mitchgu/6301-temp-sensor/Deliverables/deliverable_4.docx

Deliverable 4 – Mitchell Gu

I don’t have a screenshot with a different temperature because I’m pretty sure it’s IPTAT now.

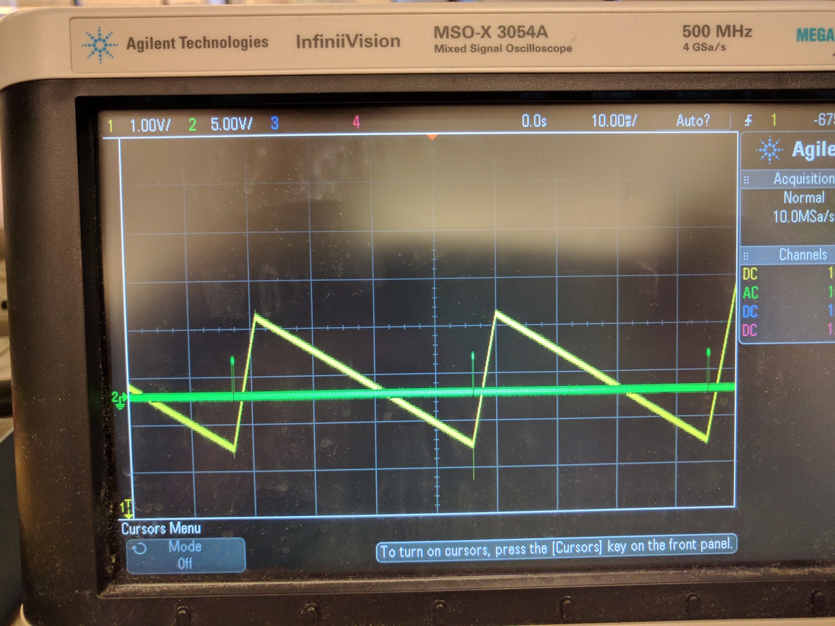
[picture p6: figure]
