mitchgu/6301-temp-sensor/Deliverables/deliverable_2.docx

# 6.301 Project Deliverable 2 – Simulation

# SPICE Simulation

Used a super simple model with same beta as hand calculations:

.model NPN NPN(IS=1E-14 Bf=100 RB=0 RC=0 RE=0)

.model PNP PNP(IS=1E-14 Bf=100 RB=0 RC=0 RE=0)

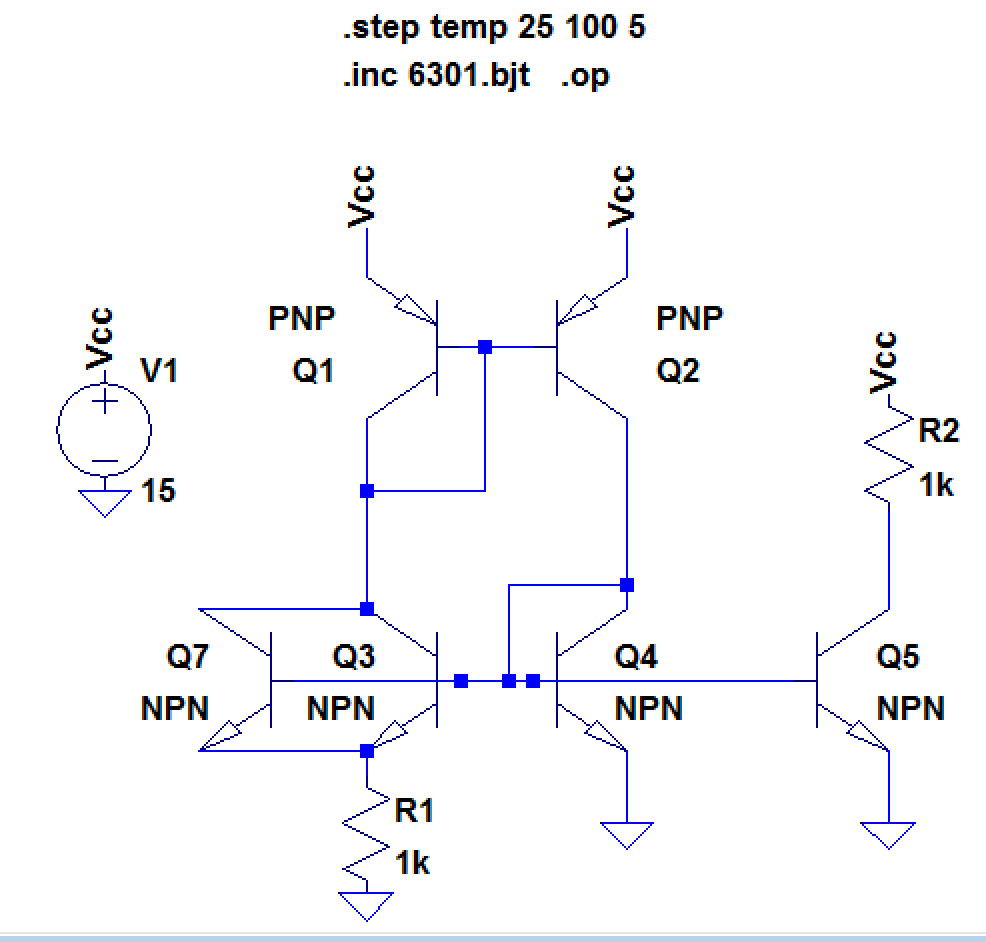
[picture p7: figure]
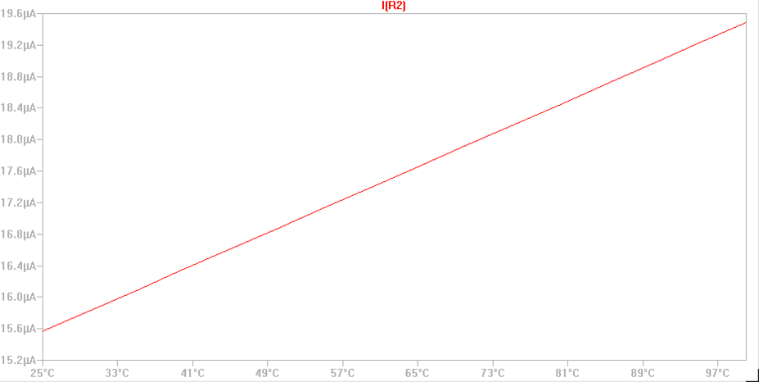
[picture p8: figure]

# Hand calculation vs SPICE simulation

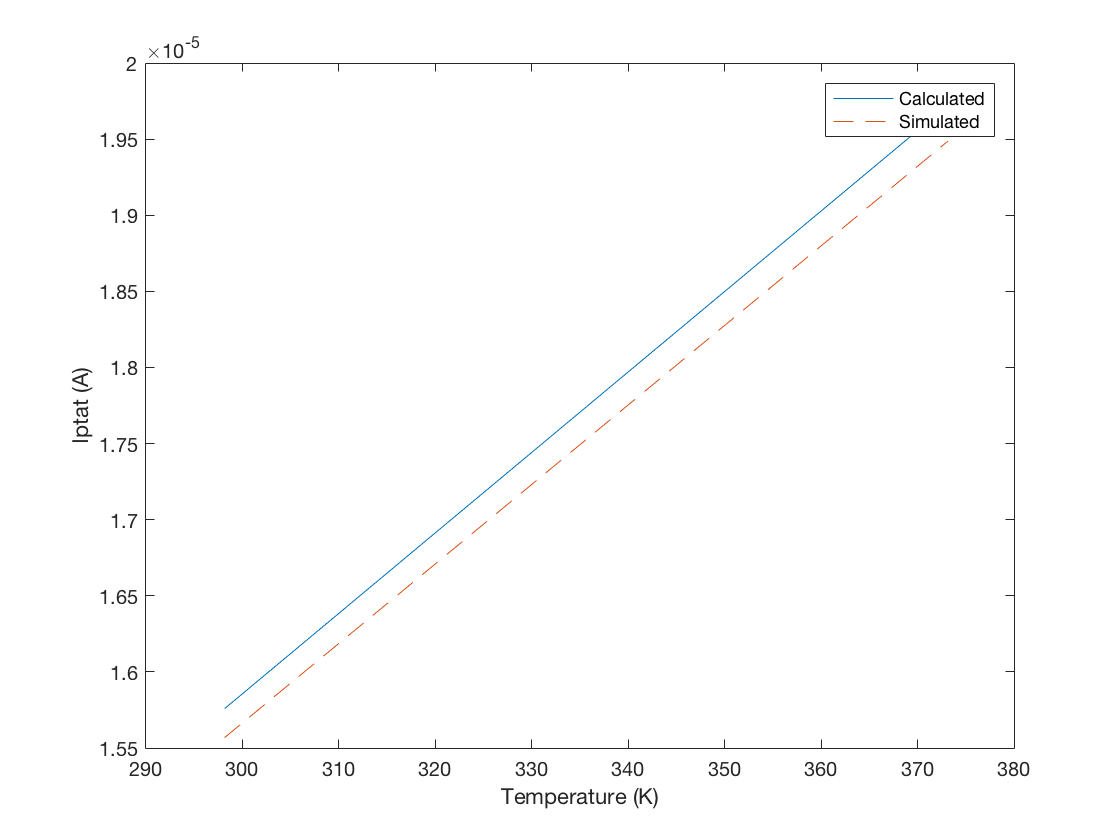
[picture p9: figure]
