mitchgu/6301-temp-sensor/Report/assets/img/adc_sch.png

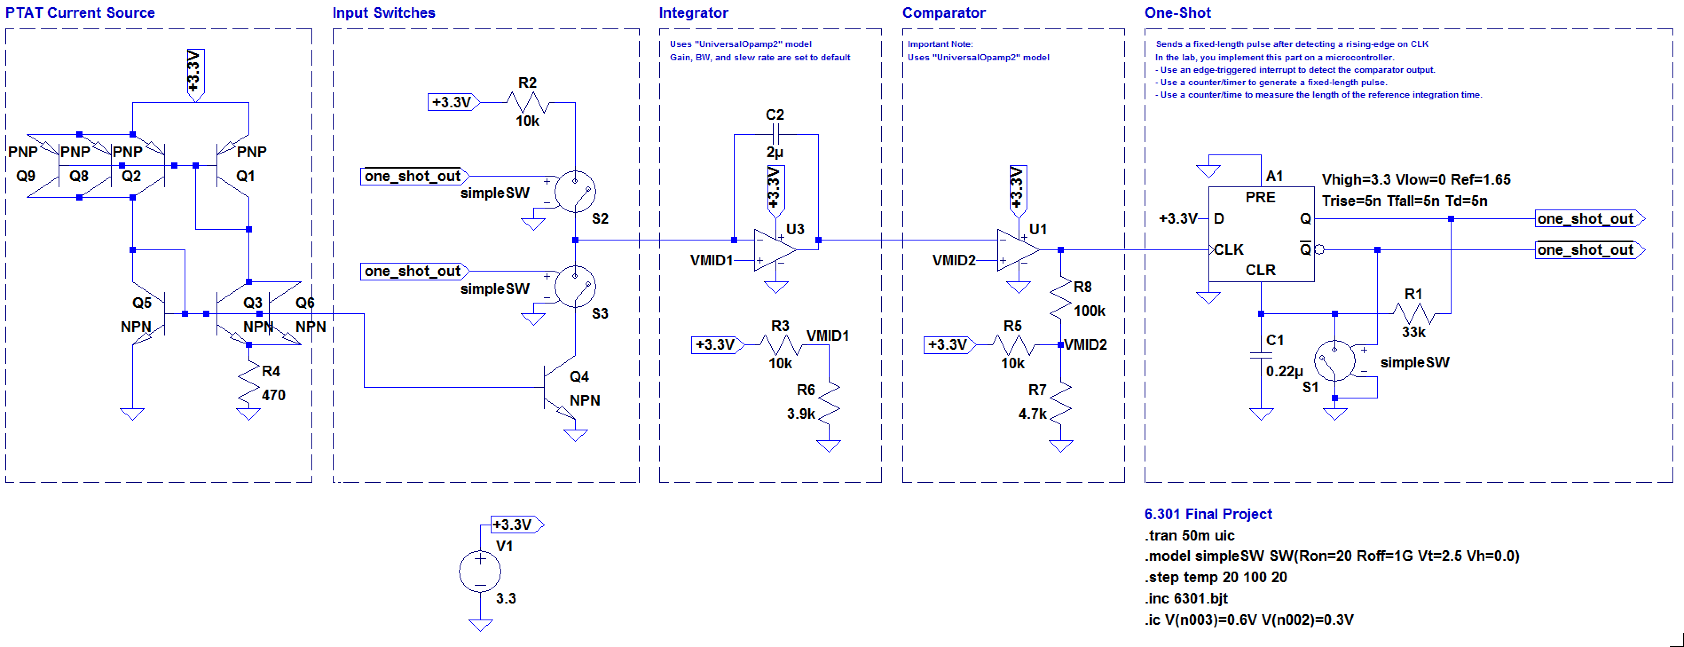
Report/assets/img/adc_sch.png
