mitchgu/6301-temp-sensor/Report/assets/img/adc_sim.png

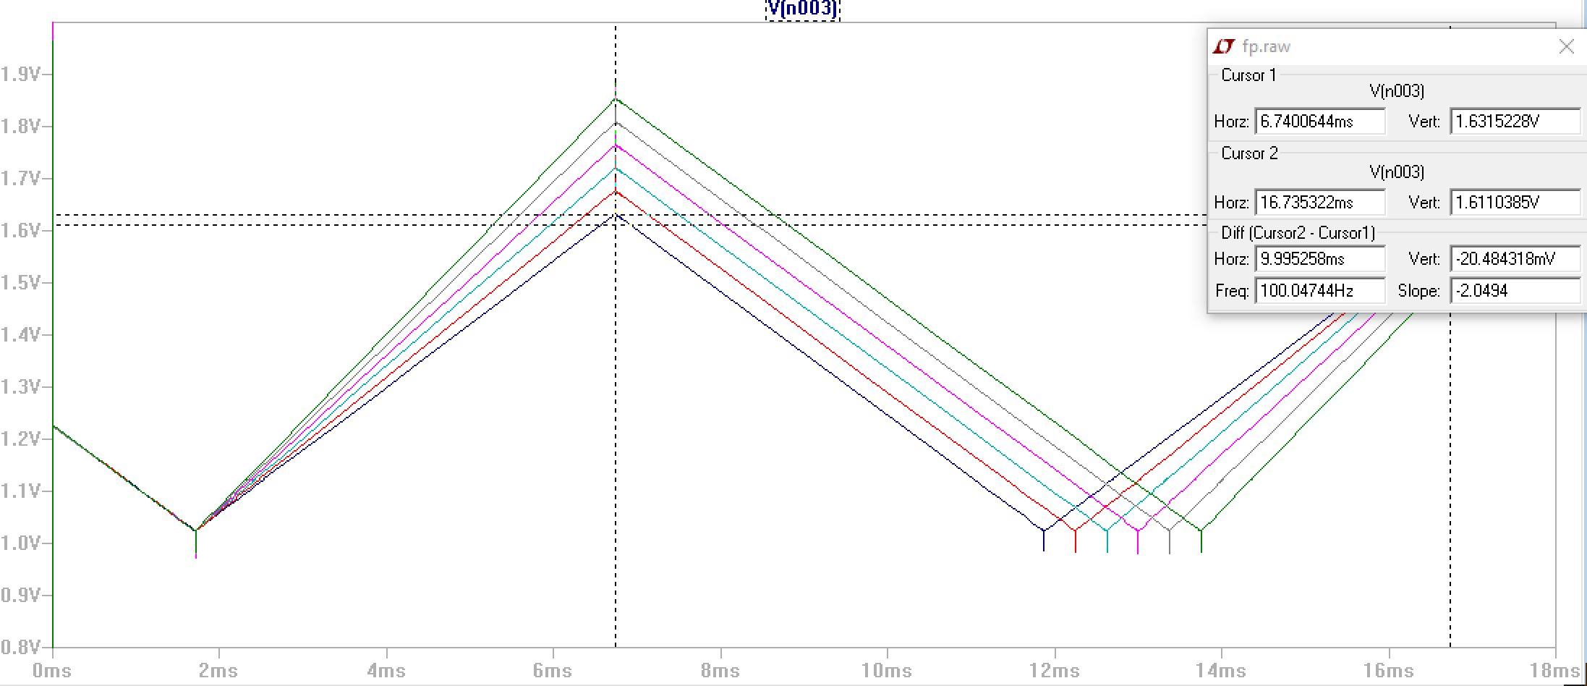
Report/assets/img/adc_sim.png
