mitchgu/6301-temp-sensor/Report/assets/img/downramptime.png

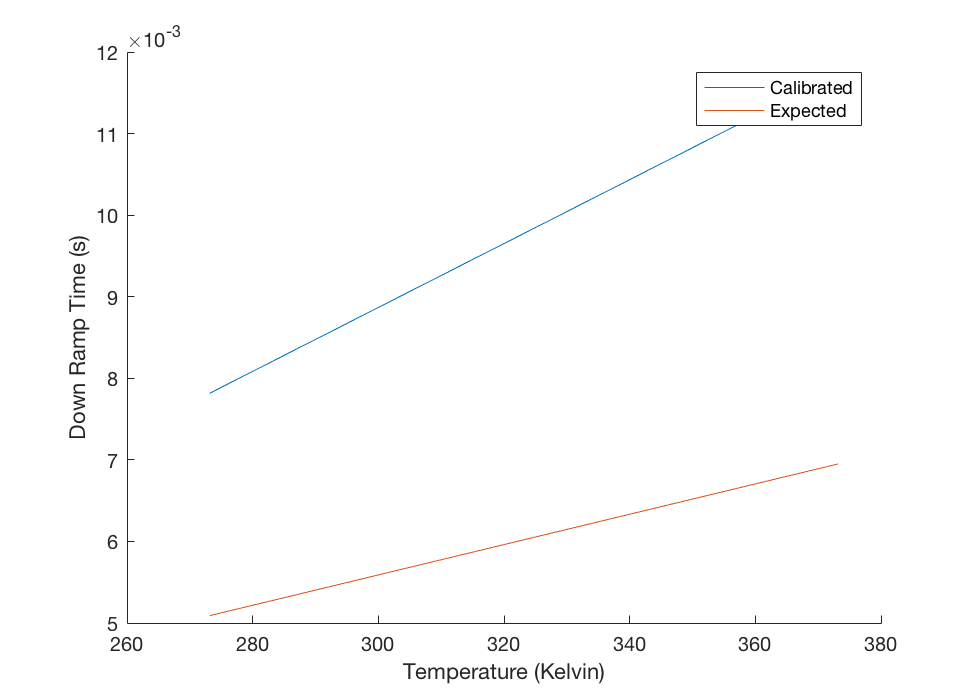
Report/assets/img/downramptime.png
