mitchgu/6301-temp-sensor/Report/assets/img/pcb_bottom_cu.png

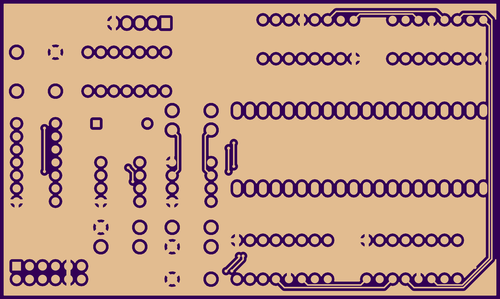
Report/assets/img/pcb_bottom_cu.png
