mitchgu/6301-temp-sensor/Report/assets/img/pcb_top.png

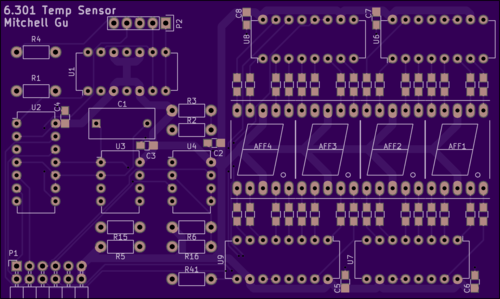
Report/assets/img/pcb_top.png
