mitchgu/6301-temp-sensor/Report/assets/img/ptat_cell.png

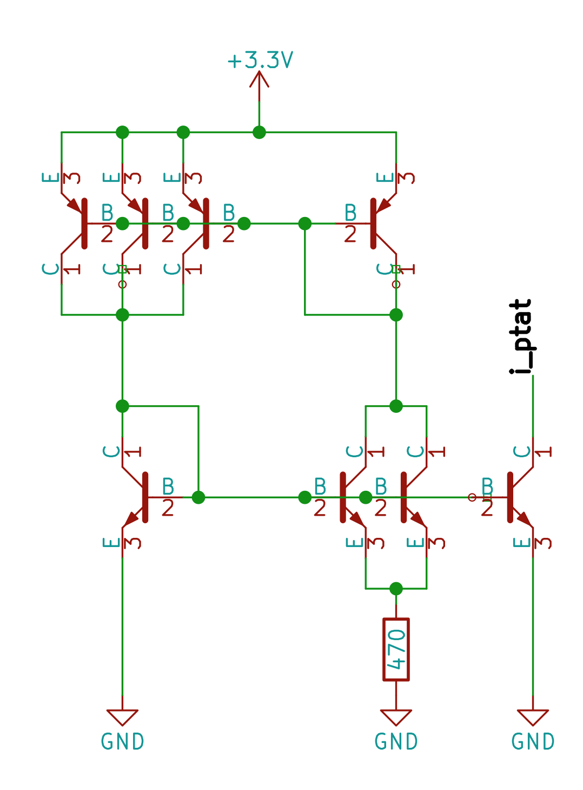
Report/assets/img/ptat_cell.png
