mitchgu/6301-temp-sensor/Report/assets/img/ptat_sim.png

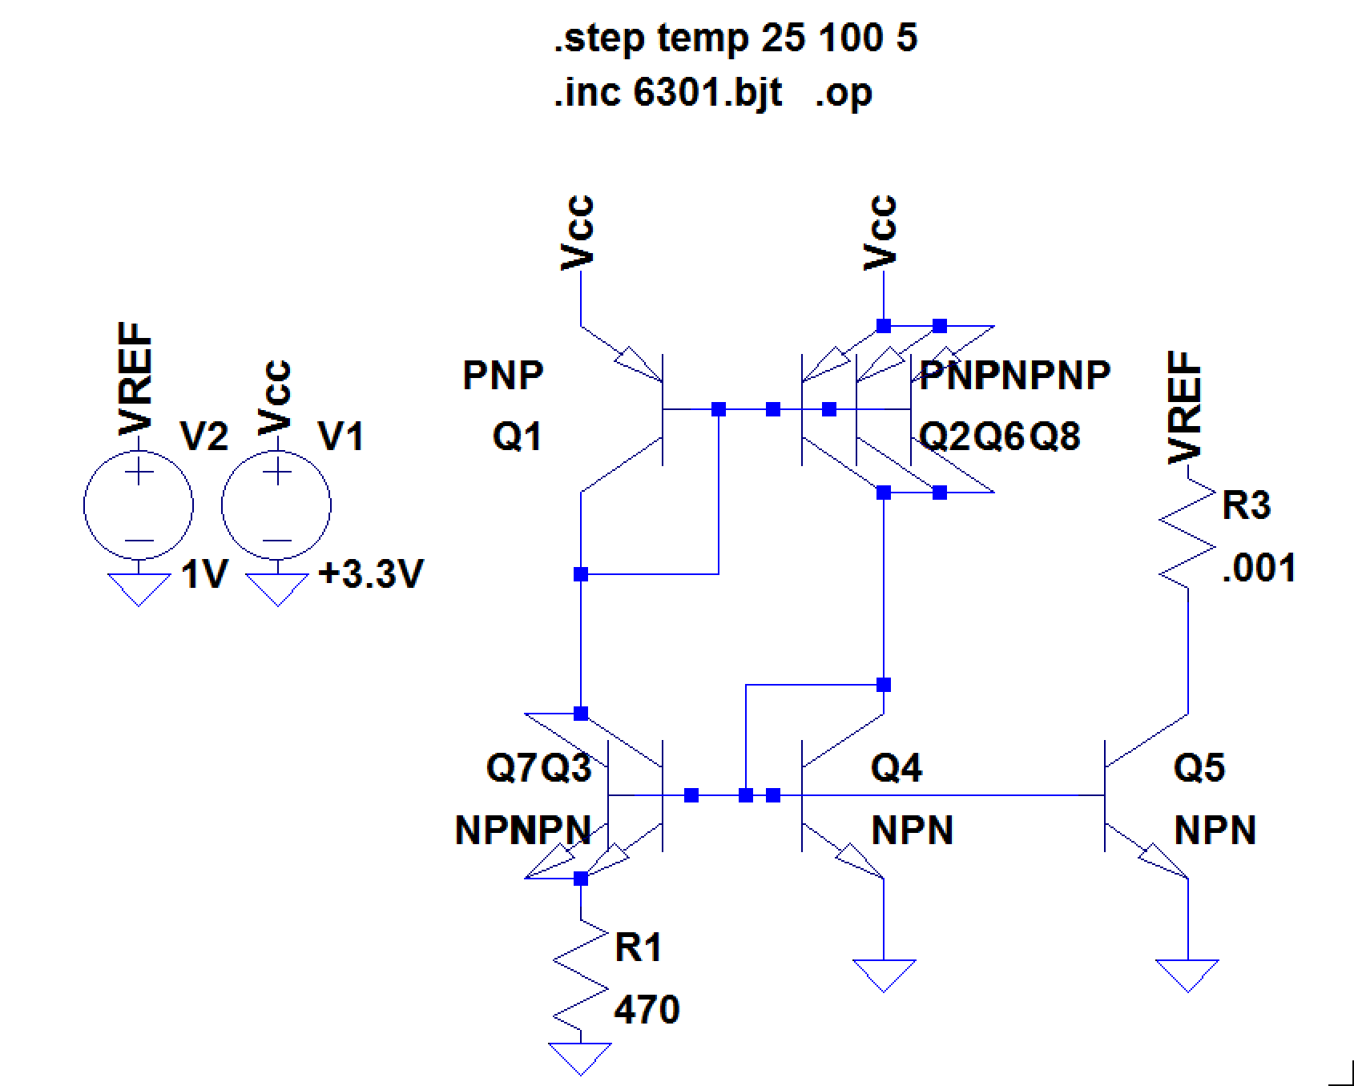
Report/assets/img/ptat_sim.png
