mitchgu/6301-temp-sensor/Report/assets/img/sch.png

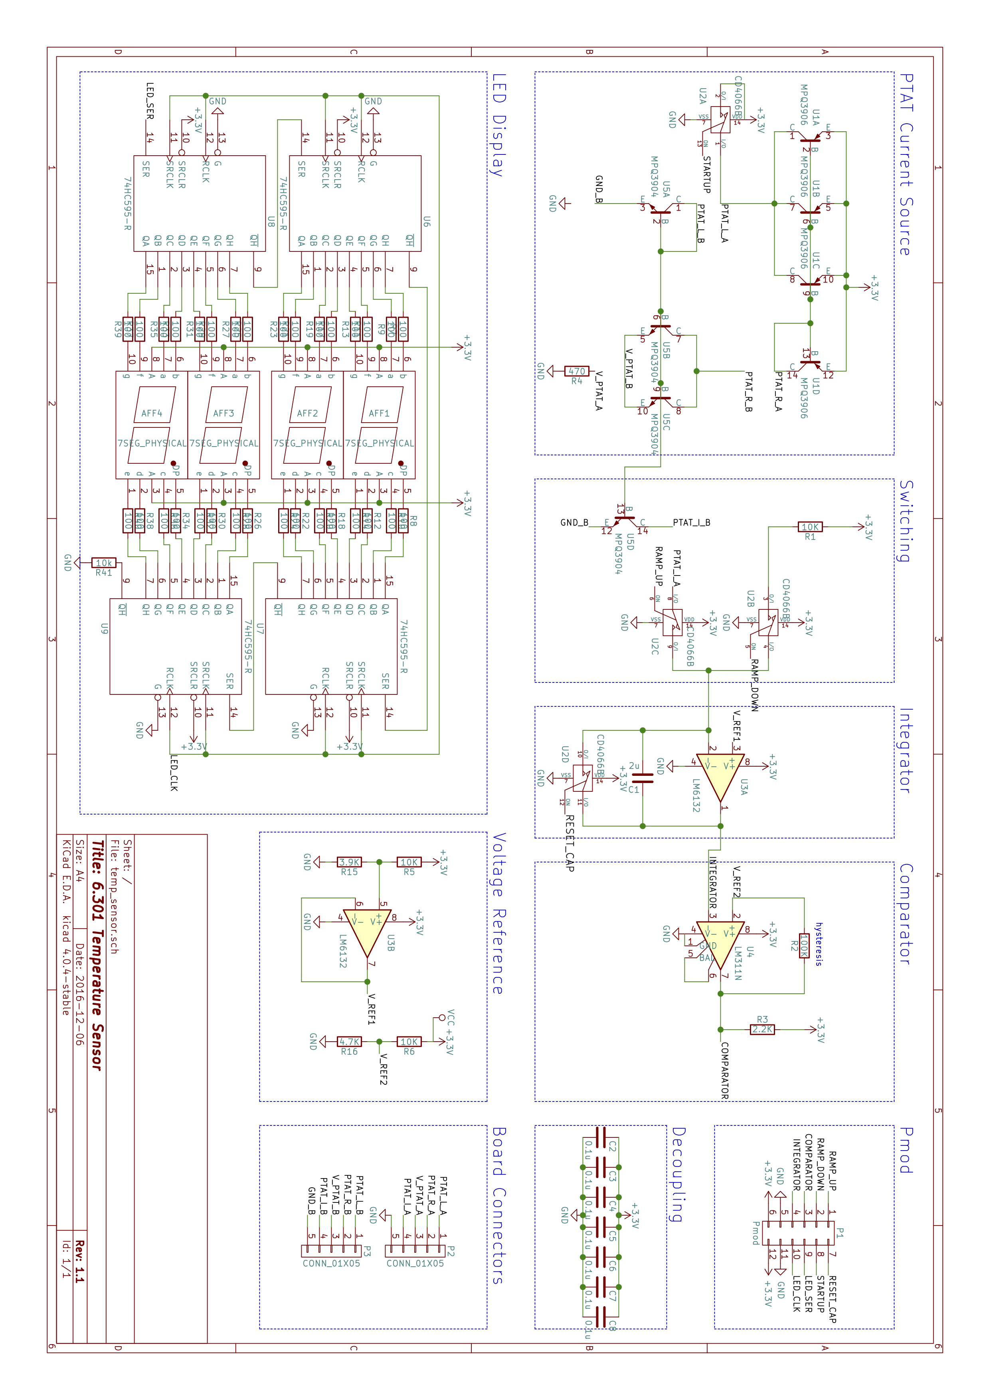
Report/assets/img/sch.png
