mitchgu/6301-temp-sensor/Report/assets/img/silk.png

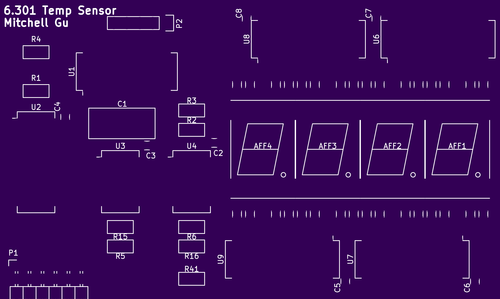
Report/assets/img/silk.png
