mitchgu/6301-temp-sensor/Report/assets/img/temp_plot.png

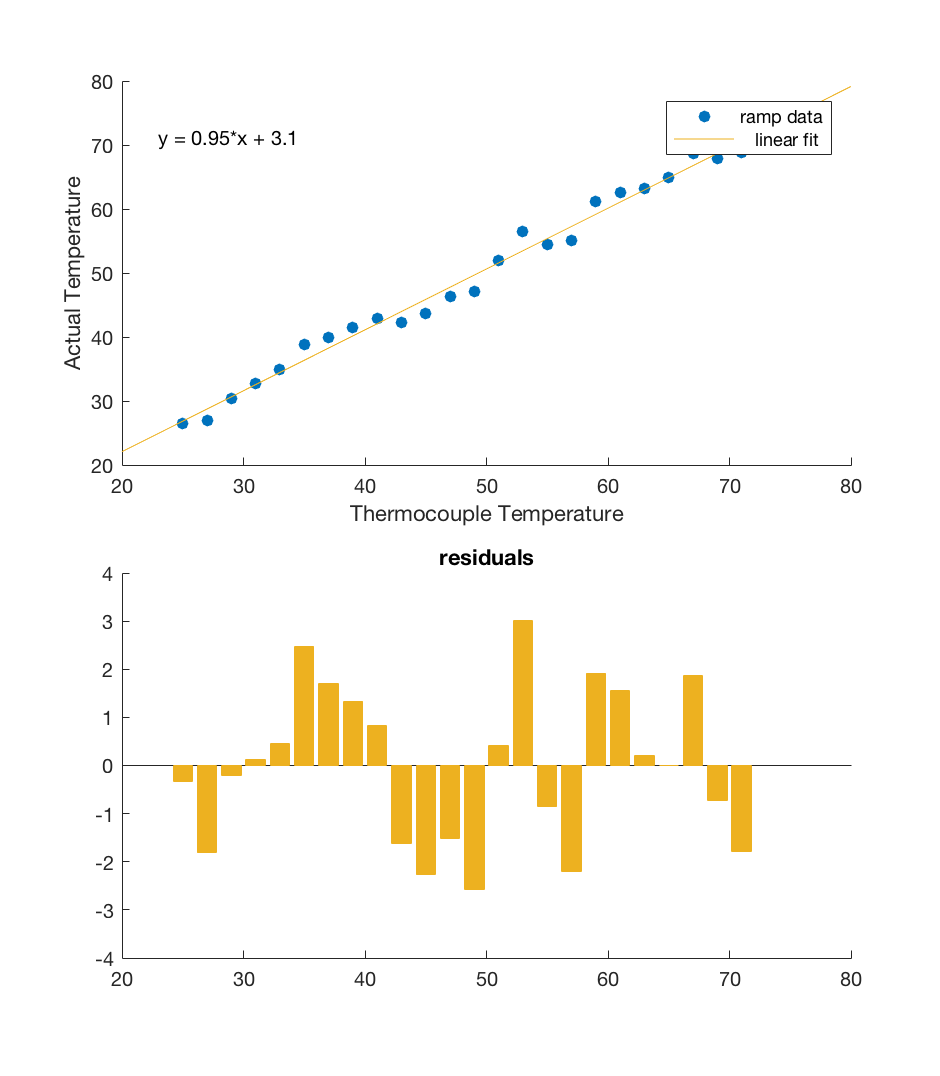
Report/assets/img/temp_plot.png
