mitchgu/6301-temp-sensor/kicad/temp_sensor.pdf

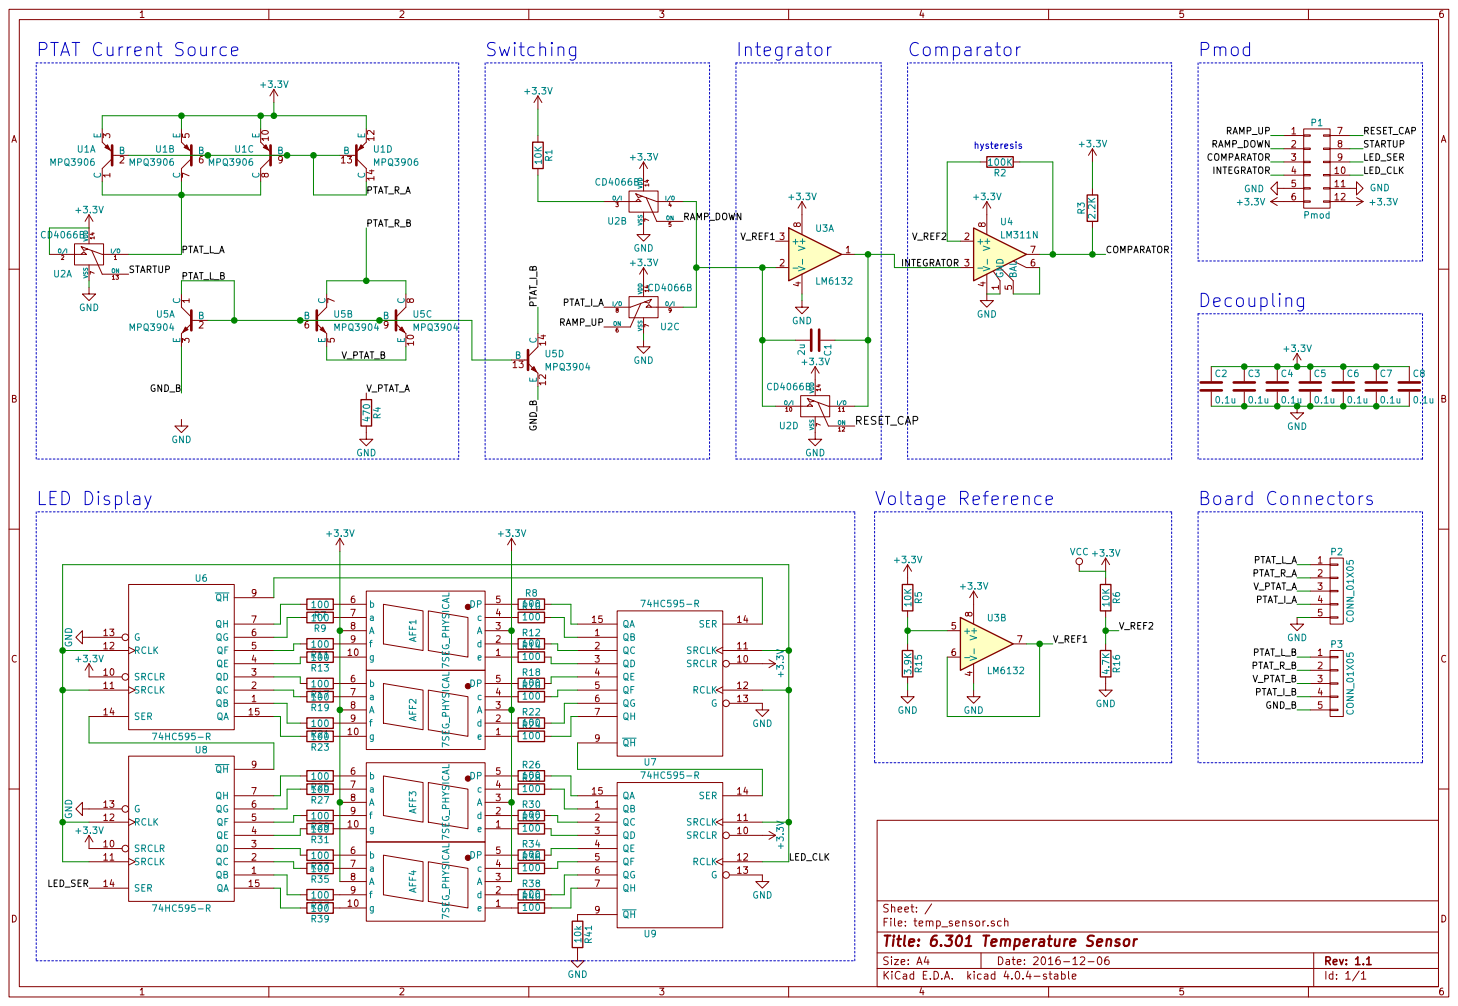
[picture p21: page 1]

f 9 | 2 A

Id: 1/1 Title: 6.301 Temperature Sensor
