mitchgu/6301-temp-sensor/LTSpice/fp.asc

A1: dflop; Vhigh=3.3 Vlow=0 Ref=1.65; Trise=5n Tfall=5n Td=5n
C1: cap; 0.22µ
C2: cap; 2µ
Q1: pnp
Q2: pnp
Q3: npn
Q4: npn
Q5: npn
Q6: npn
Q8: pnp
Q9: pnp
R1: res; 33k
R2: res; 10k
R3: res; 10k
R4: res; 470
R5: res; 10k
R6: res; 3.9k
R7: res; 4.7k
R8: res; 100k
S1: sw; simpleSW
S2: sw; simpleSW
S3: sw; simpleSW
U1: UniversalOpamp2
U2: UniversalOpamp2
U3: UniversalOpamp2
V1: voltage; 3.3
Named nets: 0, +3.3V, one_shot_out, _one_shot_out, VMID1, VMID2
.tran 50m uic
.model simpleSW SW(Ron=20 Roff=1G Vt=2.5 Vh=0.0)
Input Switches
Integrator
Comparator
One-Shot
Sends a fixed-length pulse after detecting a rising-edge on CLK
In the lab, you implement this part on a microcontroller.
- Use an edge-triggered interrupt to detect the comparator output.
- Use a counter/timer to generate a fixed-length pulse.
- Use a counter/time to measure the length of the reference integration time.
Uses "UniversalOpamp2" model
Gain, BW, and slew rate are set to default
Important Note:
Uses "UniversalOpamp2" model
6.301 Final Project
.inc 6301.bjt
.step temp 20 100 20
PTAT Current Source
.ic V(n003)=0.6V V(n002)=0.3V
