mitchgu/6301-temp-sensor/LTSpice/ptat.asc

Q1: pnp
Q2: pnp
Q3: npn
Q4: npn
Q5: npn
Q6: pnp
Q7: npn
Q8: pnp
R1: res; 470
R3: res; .001
V1: voltage; +3.3V
V2: voltage; 1V
Named nets: 0, Vcc, VREF
.inc 6301.bjt
.op
.step temp 25 100 5
