mitchgu/6301-temp-sensor/kicad/temp_sensor.kicad_pcb

## KiCad design kicad/temp_sensor.kicad_pcb (2016-12-13)

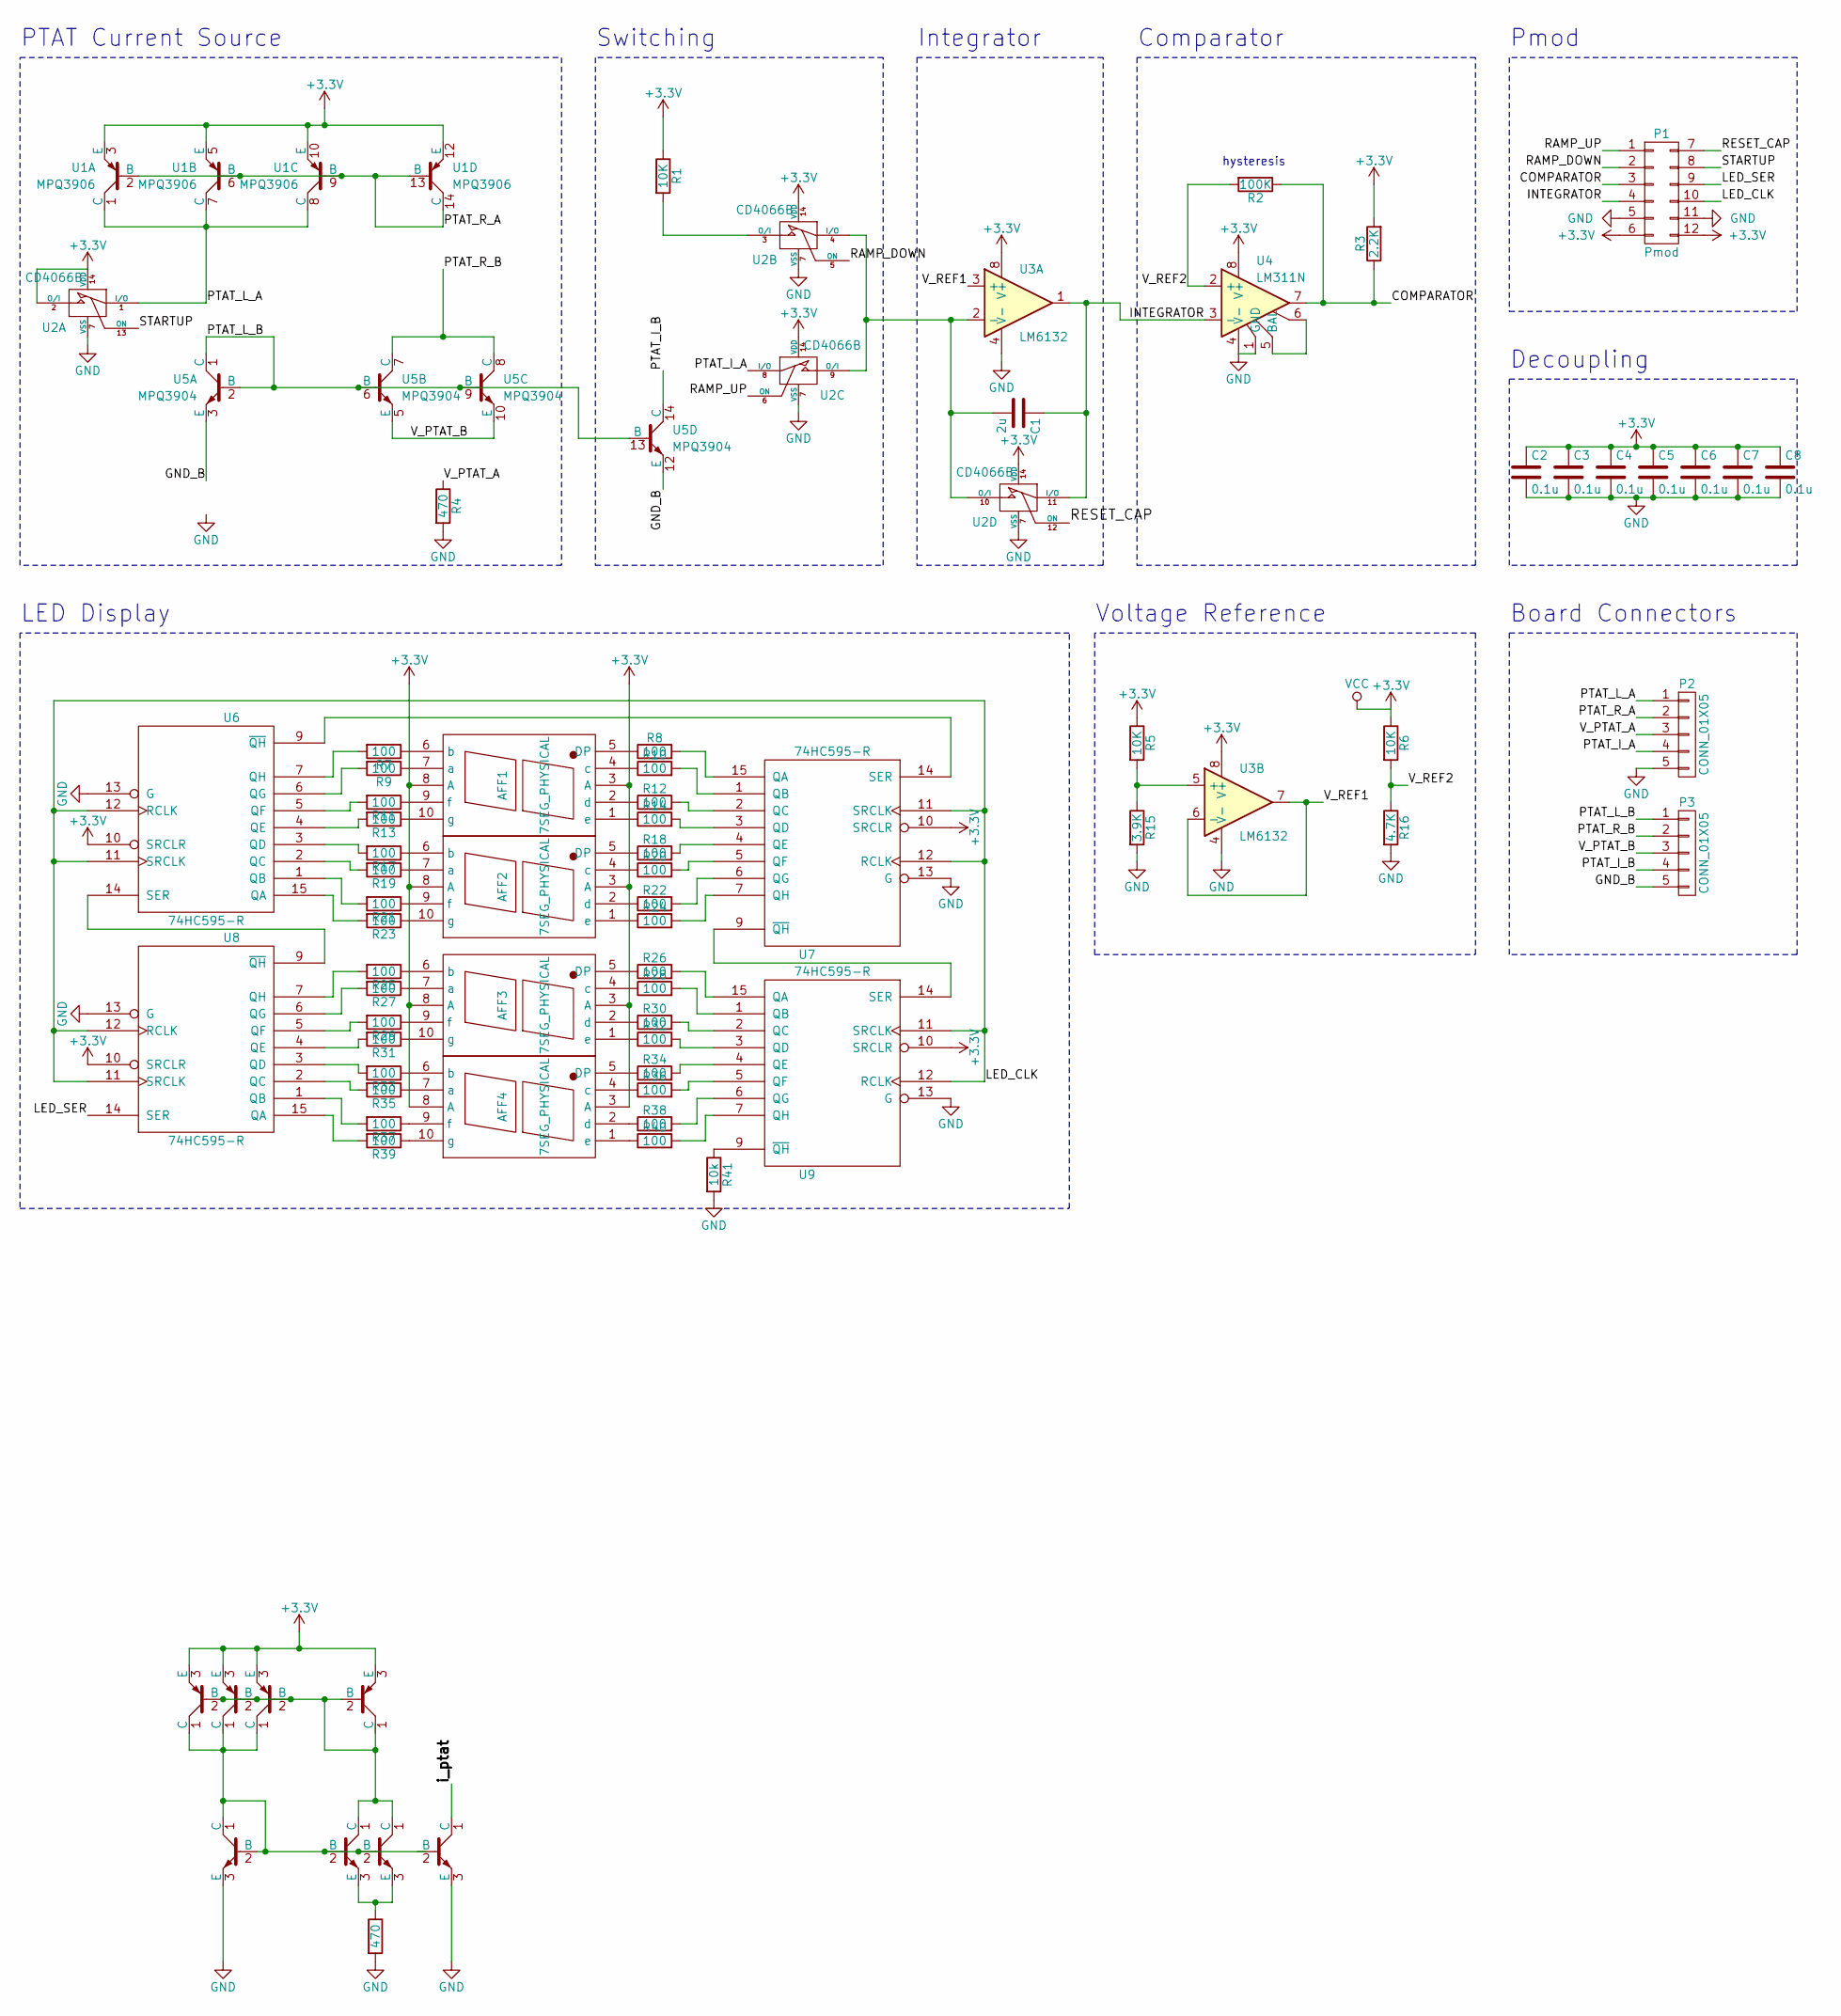
[picture p22: schematic temp_sensor.sch, 6.301 Temperature Sensor]

Parts:
AFF1, AFF2, AFF3, AFF4: 7SEG_PHYSICAL; 7SegmentLED_LTS6760_LTS6780
C1: 2u; C_Rect_L13_W6_H12_P10
C2, C3, C4, C5, C6, C7, C8: 0.1u; C_0805_HandSoldering
P1: Pmod; Pmod_Male
P2, P3: CONN_01X05; Pin_Header_Straight_1x05
R1, R5, R6: 10K; Resistor_Horizontal_RM7mm
R2: 100K; Resistor_Horizontal_RM7mm
R3: 2.2K; Resistor_Horizontal_RM7mm
R4: 470; Resistor_Horizontal_RM7mm
R7, R8, R9, R10, R11, R12, R13, R14, R17, R18, R19, R20, R21, R22, R23, R24, R25, R26, R27, R28, R29, R30, R31, R32, R33, R34, R35, R36, R37, R38, R39, R40: 100; R_0805_HandSoldering
R15: 3.9K; Resistor_Horizontal_RM7mm
R16: 4.7K; Resistor_Horizontal_RM7mm
R41: 10k; Resistor_Horizontal_RM7mm
U1: MPQ3906; DIP-14_W7.62mm
U2: CD4066B; DIP-14_W7.62mm
U3: LM6132; DIP-8_W7.62mm
U4: LM311N; DIP-8_W7.62mm
U5: MPQ3904; DIP-14_W7.62mm
U6, U7, U8, U9: 74HC595-R; DIP-16_W7.62mm

Connections:
+3V3: AFF1.3 (A), AFF1.8 (A), AFF2.3 (A), AFF2.8 (A), AFF3.3 (A), AFF3.8 (A), AFF4.3 (A), AFF4.8 (A), C2.1, C3.1, C4.1, C5.1, C6.1, C7.1, C8.1, P1.6, P1.12, R1.1, R3.2, R5.1, R6.1, U1.3 (E), U1.5 (E), U1.10 (E), U1.12 (E), U2.2 (O/I), U2.14 (VDD), U3.8 (V+), U4.8 (V+), U6.10 (SRCLR), U6.16 (VCC), U7.10 (SRCLR), U7.16 (VCC), U8.10 (SRCLR), U8.16 (VCC), U9.10 (SRCLR), U9.16 (VCC)
/COMPARATOR: P1.3, R2.1, R3.1, U4.7
/INTEGRATOR: C1.1, P1.4, U2.11 (I/O), U3.1, U4.3 (-)
/LED_CLK: P1.10, U6.11 (SRCLK), U6.12 (RCLK), U7.11 (SRCLK), U7.12 (RCLK), U8.11 (SRCLK), U8.12 (RCLK), U9.11 (SRCLK), U9.12 (RCLK)
/LED_SER: P1.9, U8.14 (SER)
/PTAT_I_A: P2.4, U2.8 (I/O)
/PTAT_L_A: P2.1, U1.1 (C), U1.7 (C), U1.8 (C), U2.1 (I/O)
/PTAT_R_A: P2.2, U1.2 (B), U1.6 (B), U1.9 (B), U1.13 (B), U1.14 (C)
/RAMP_DOWN: P1.2, U2.5 (ON)
/RAMP_UP: P1.1, U2.6 (ON)
/RESET_CAP: P1.7, U2.12 (ON)
/STARTUP: P1.8, U2.13 (ON)
/V_PTAT_A: P2.3, R4.1
/V_REF1: U3.3 (+), U3.6 (-), U3.7
/V_REF2: R2.2, R6.2, R16.1, U4.2 (+)
GND: C2.2, C3.2, C4.2, C5.2, C6.2, C7.2, C8.2, P1.5, P1.11, P2.5, R4.2, R15.2, R16.2, R41.2, U2.7 (VSS), U3.4 (V-), U4.1 (GND), U4.4 (V-), U6.8 (GND), U6.13 (G), U7.8 (GND), U7.13 (G), U8.8 (GND), U8.13 (G), U9.8 (GND), U9.13 (G)
unnamed: AFF1.1 (e), R14.1
unnamed: AFF1.2 (d), R12.1
unnamed: AFF1.4 (c), R10.1
unnamed: AFF1.5 (DP), R8.1
unnamed: AFF1.6 (b), R7.1
unnamed: AFF1.7 (a), R9.1
unnamed: AFF1.9 (f), R11.1
unnamed: AFF1.10 (g), R13.1
unnamed: AFF2.1 (e), R24.1
unnamed: AFF2.2 (d), R22.1
unnamed: AFF2.4 (c), R20.1
unnamed: AFF2.5 (DP), R18.1
unnamed: AFF2.6 (b), R17.1
unnamed: AFF2.7 (a), R19.1
unnamed: AFF2.9 (f), R21.1
unnamed: AFF2.10 (g), R23.1
unnamed: AFF3.1 (e), R32.1
unnamed: AFF3.2 (d), R30.1
unnamed: AFF3.4 (c), R28.1
unnamed: AFF3.5 (DP), R26.1
unnamed: AFF3.6 (b), R25.1
unnamed: AFF3.7 (a), R27.1
unnamed: AFF3.9 (f), R29.1
unnamed: AFF3.10 (g), R31.1
unnamed: AFF4.1 (e), R40.1
unnamed: AFF4.2 (d), R38.1
unnamed: AFF4.4 (c), R36.1
unnamed: AFF4.5 (DP), R34.1
unnamed: AFF4.6 (b), R33.1
unnamed: AFF4.7 (a), R35.1
unnamed: AFF4.9 (f), R37.1
unnamed: AFF4.10 (g), R39.1
unnamed: C1.2, U2.4 (I/O), U2.9 (O/I), U2.10 (O/I), U3.2 (-)
unnamed: P3.1, U5.1 (C), U5.2 (B), U5.6 (B), U5.9 (B), U5.13 (B)
unnamed: P3.2, U5.7 (C), U5.8 (C)
unnamed: P3.3, U5.5 (E), U5.10 (E)
unnamed: P3.4, U5.14 (C)
unnamed: P3.5, U5.3 (E), U5.12 (E)
unnamed: R1.2, U2.3 (O/I)
unnamed: R7.2, U6.7 (QH)
unnamed: R8.2, U7.15 (QA)
unnamed: R9.2, U6.6 (QG)
unnamed: R10.2, U7.1 (QB)
unnamed: R11.2, U6.5 (QF)
unnamed: R12.2, U7.2 (QC)
unnamed: R13.2, U6.4 (QE)
unnamed: R14.2, U7.3 (QD)
unnamed: R5.2, R15.1, U3.5 (+)
unnamed: R17.2, U6.3 (QD)
unnamed: R18.2, U7.4 (QE)
unnamed: R19.2, U6.2 (QC)
unnamed: R20.2, U7.5 (QF)
unnamed: R21.2, U6.1 (QB)
unnamed: R22.2, U7.6 (QG)
unnamed: R23.2, U6.15 (QA)
unnamed: R24.2, U7.7 (QH)
unnamed: R25.2, U8.7 (QH)
unnamed: R26.2, U9.15 (QA)
unnamed: R27.2, U8.6 (QG)
unnamed: R28.2, U9.1 (QB)
unnamed: R29.2, U8.5 (QF)
unnamed: R30.2, U9.2 (QC)
unnamed: R31.2, U8.4 (QE)
unnamed: R32.2, U9.3 (QD)
unnamed: R33.2, U8.3 (QD)
unnamed: R34.2, U9.4 (QE)
unnamed: R35.2, U8.2 (QC)
unnamed: R36.2, U9.5 (QF)
unnamed: R37.2, U8.1 (QB)
unnamed: R38.2, U9.6 (QG)
unnamed: R39.2, U8.15 (QA)
unnamed: R40.2, U9.7 (QH)
unnamed: R41.1, U9.9 (~QH)
unnamed: U4.5 (BAL), U4.6
unnamed: U6.9 (~QH), U7.14 (SER)
unnamed: U6.14 (SER), U8.9 (~QH)
unnamed: U7.9 (~QH), U9.14 (SER)

Notes on the sheet:
PTAT Current Source
Switching
Integrator
Comparator
hysteresis
Pmod
Voltage Reference
LED Display
Decoupling
Board Connectors

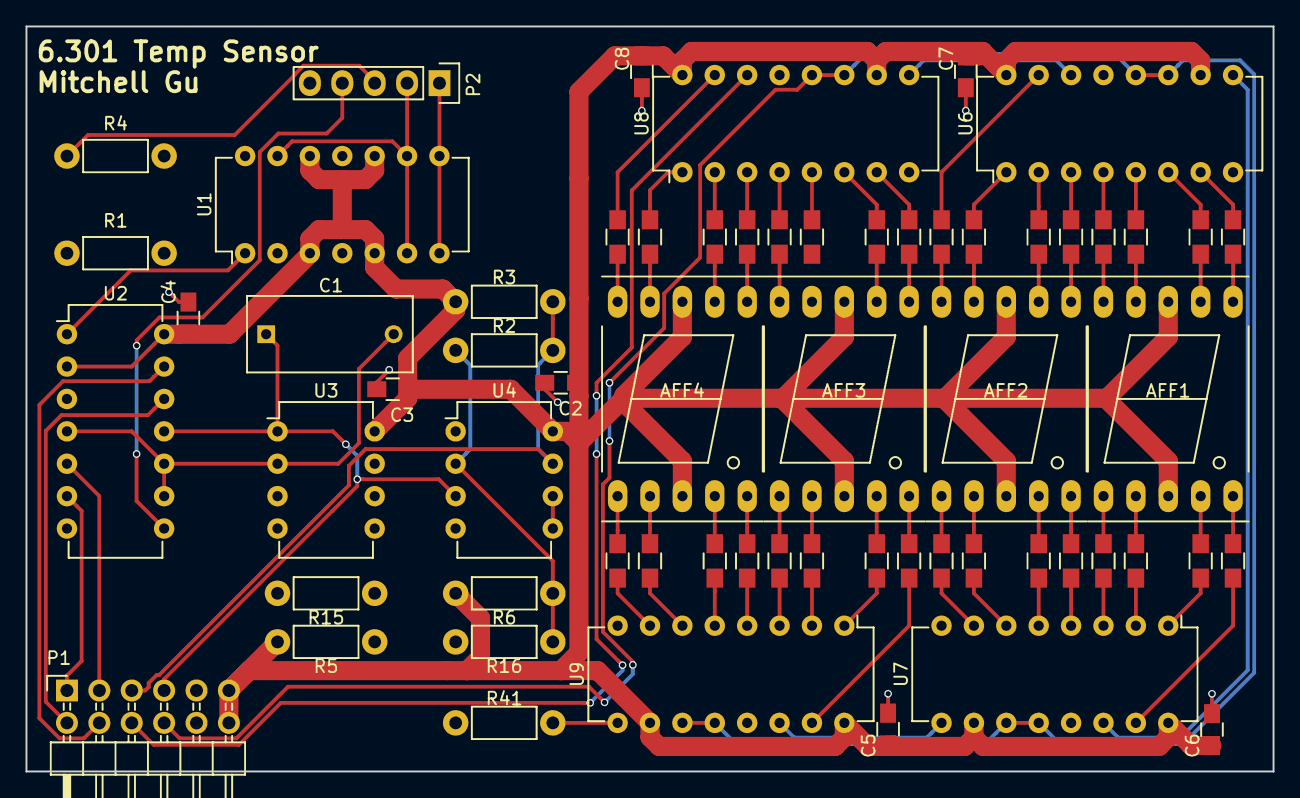
[picture p23: board temp_sensor.kicad_pcb from above]

Board: 2 copper layers, 97.8 x 58.4 mm, 63 parts (0 on the bottom side), 88 nets.
